dukelec/cdstep/doc/cdstep_v3.jpg

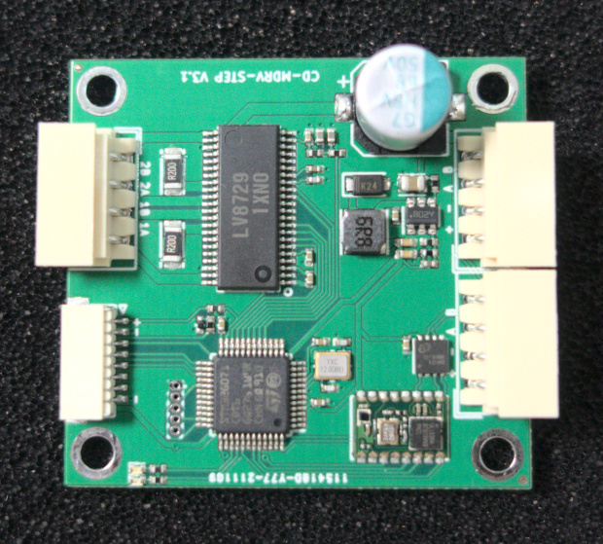
doc/cdstep_v3.jpg
