dukelec/cdstep/hardware/cdstep_pcb_v3.1.png

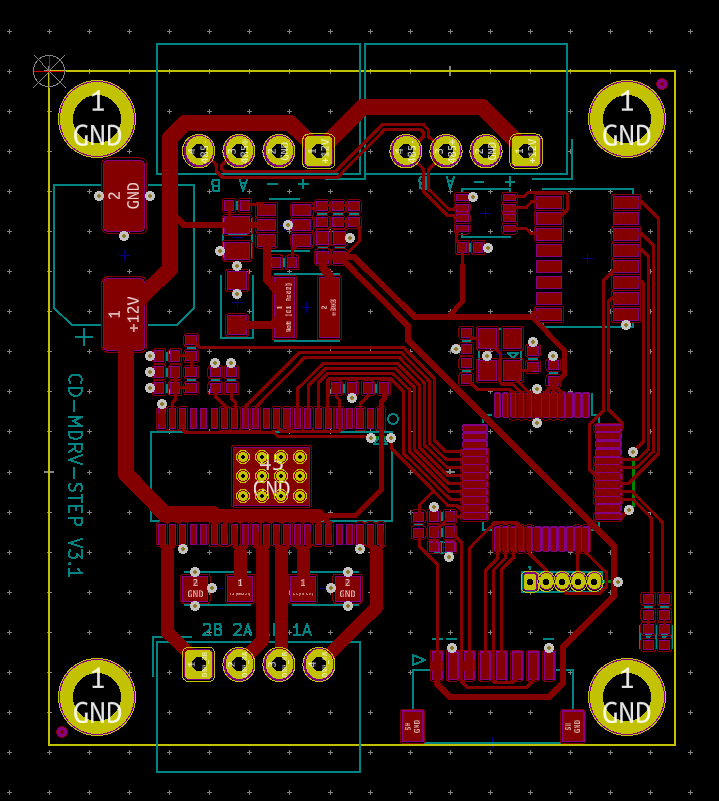
hardware/cdstep_pcb_v3.1.png
