dukelec/cdstep/hardware/cdstep_pcb_v4.1.png

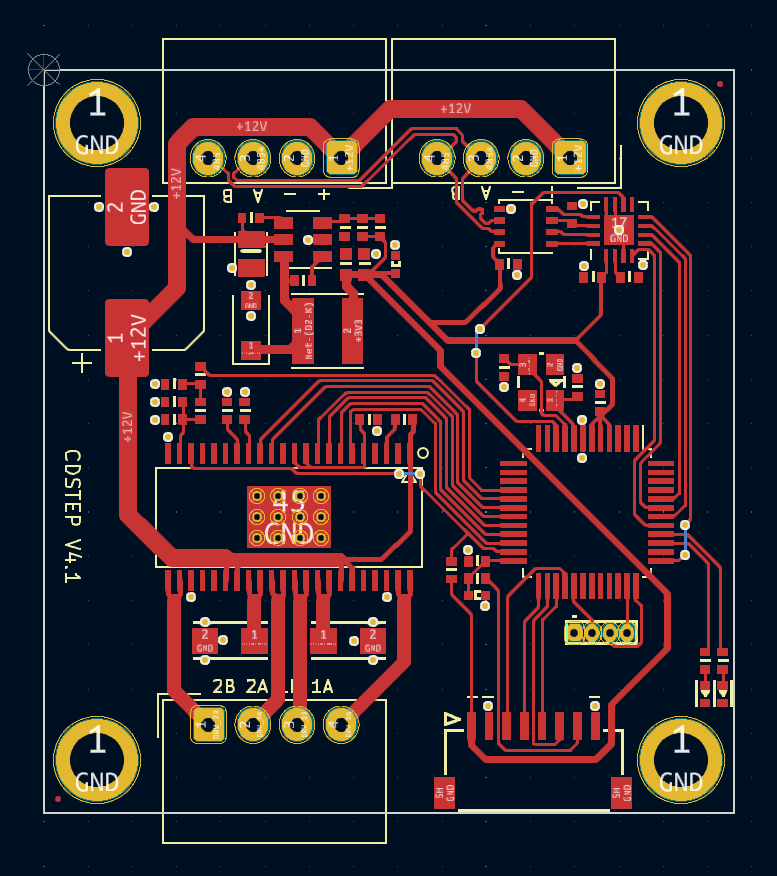
hardware/cdstep_pcb_v4.1.png
