dukelec/cdstep/hardware/cdstep_sch_v4.1.pdf

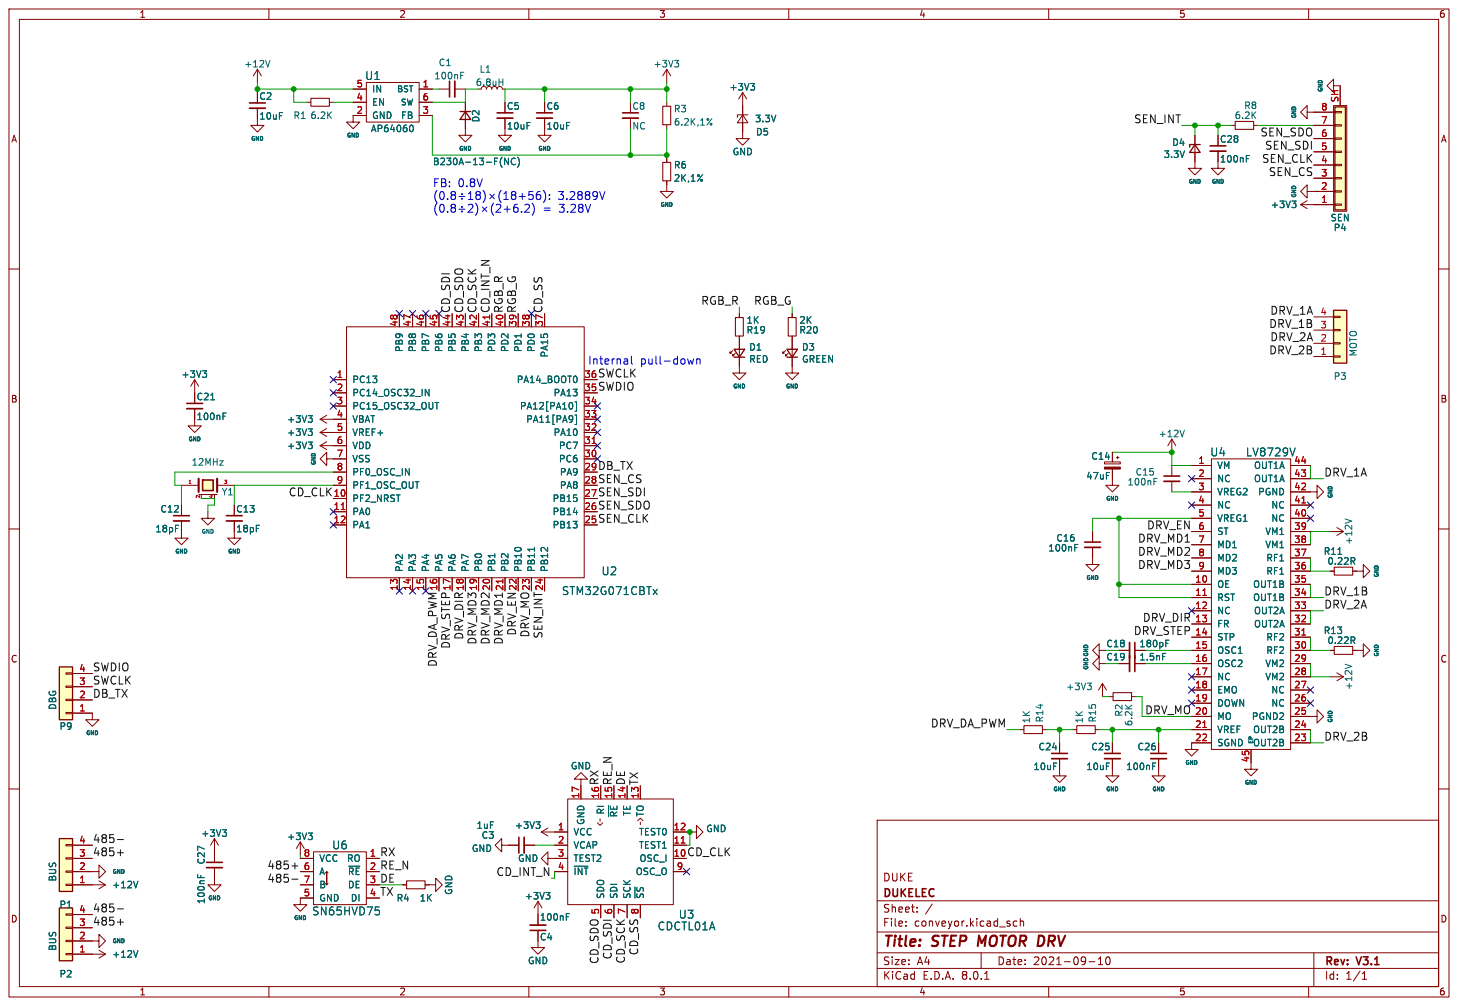
[picture p9: page 1]

DUKE
File: conveyor.kicad_sch Sheet: / DUKELEC

Id: 1/1 Title: STEP MOTOR DRV
