dukelec/cdstep/hardware/cdstep_sch_v3.1.pdf

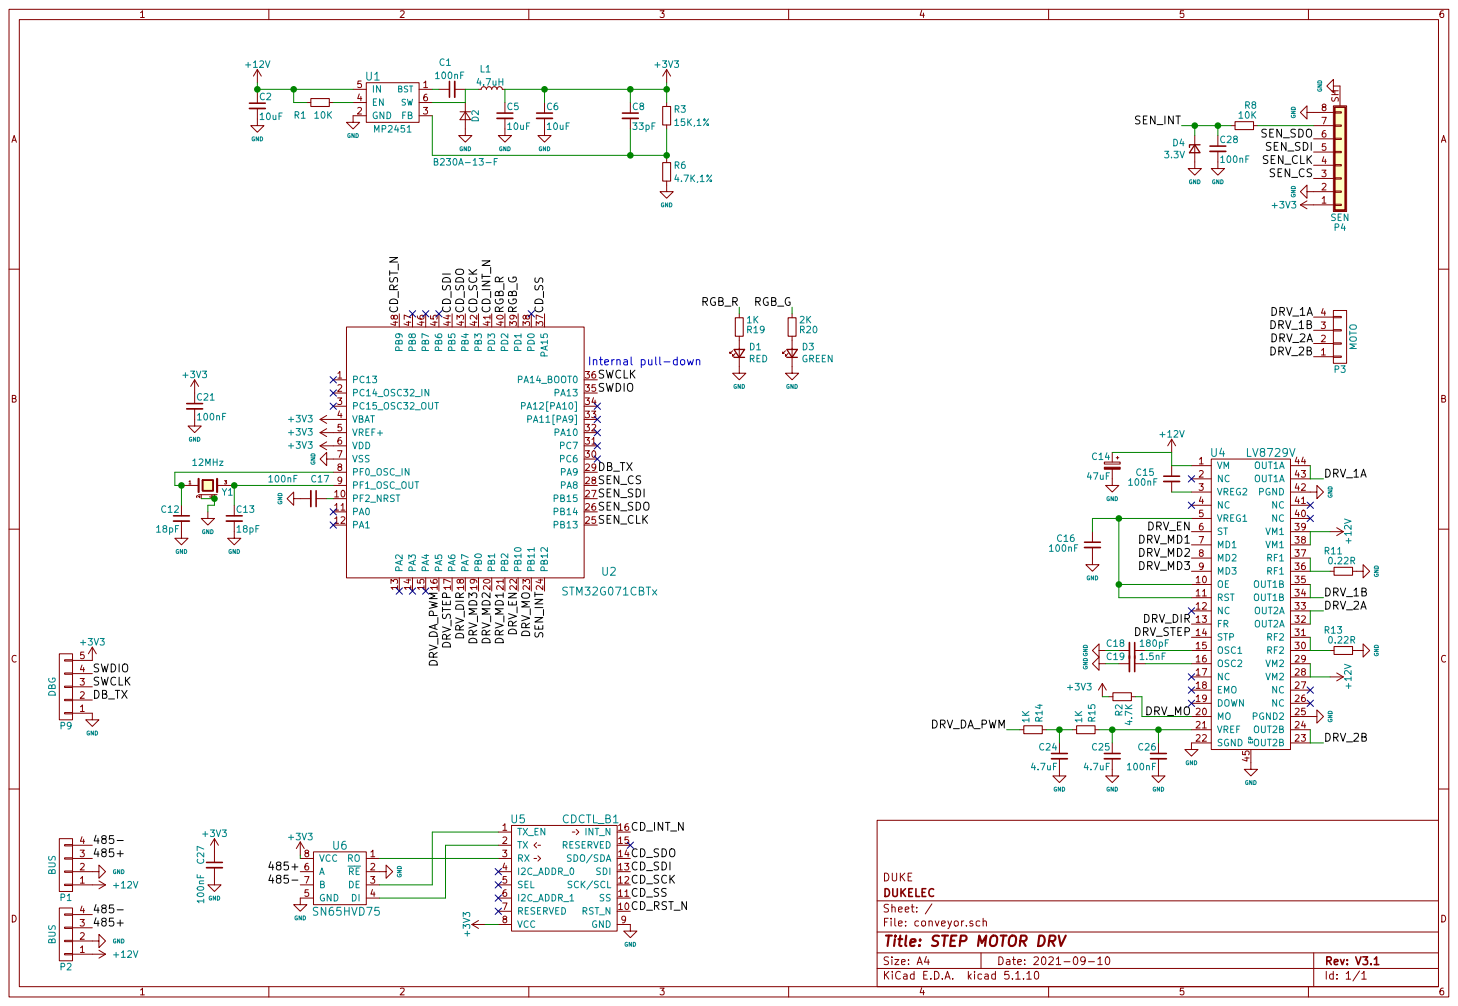
[picture p10: page 1]

DUKE
File: conveyor.sch Sheet: / DUKELEC

Id: 1/1 Title: STEP MOTOR DRV
