dukelec/cdstep/mdrv_bl/usr/app_main.c

/*
 * Software License Agreement (BSD License)
 *
 * Copyright (c) 2017, DUKELEC, Inc.
 * All rights reserved.
 *
 * Author: Duke Fong <d@d-l.io>
 */

#include "app_main.h"

extern SPI_HandleTypeDef hspi1;
extern UART_HandleTypeDef huart1;

uint32_t *bl_args = (uint32_t *)BL_ARGS;

gpio_t led_r = { .group = LED_R_GPIO_Port, .num = LED_R_Pin };
gpio_t led_g = { .group = LED_G_GPIO_Port, .num = LED_G_Pin };

uart_t debug_uart = { .huart = &huart1 };

static gpio_t r_cs = { .group = CD_CS_GPIO_Port, .num = CD_CS_Pin };
static spi_t r_spi = { .hspi = &hspi1, .ns_pin = &r_cs };

static cd_frame_t frame_alloc[FRAME_MAX];
list_head_t frame_free_head = {0};

static cdn_pkt_t packet_alloc[PACKET_MAX];
list_head_t packet_free_head = {0};

cdctl_dev_t r_dev = {0};    // CDBUS
cdn_ns_t dft_ns = {0};      // CDNET


static void device_init(void)
{
    int i;
    cdctl_cfg_t bus_cfg = {
            .mac = csa.mac,
            .baud_l = csa.baud_rate_l,
            .baud_h = csa.baud_rate_h,
            .filter_m = { csa.bus_filter_m[0], csa.bus_filter_m[1] },
            .mode = csa.bus_mode,
            .idle_wait_len = csa.bus_idle_wait_len,
            .tx_permit_len = csa.bus_tx_permit_len,
            .max_idle_len = csa.bus_max_idle_len,
            .tx_pre_len = csa.bus_tx_pre_len
    };
    cdn_init_ns(&dft_ns, &packet_free_head, &frame_free_head);

    for (i = 0; i < FRAME_MAX; i++)
        cd_list_put(&frame_free_head, &frame_alloc[i]);
    for (i = 0; i < PACKET_MAX; i++)
        cdn_list_put(&packet_free_head, &packet_alloc[i]);

    cdctl_dev_init(&r_dev, &frame_free_head, &bus_cfg, &r_spi);
    if (!csa.keep_bl) {
        cdctl_set_baud_rate(&r_dev, 115200, 115200);
        cdctl_flush(&r_dev);
    }

    cdn_add_intf(&dft_ns, &r_dev.cd_dev, 0, csa.mac);
}


#define APP_ADDR 0x08006000 // offset: 24KB

static void jump_to_app(void)
{
    static uint32_t func; // not on stack (MSP switches before use)
    uint32_t stack = *(uint32_t*)APP_ADDR;
    func = *(uint32_t*)(APP_ADDR + 4);

    gpio_set_val(&led_r, 0);
    gpio_set_val(&led_g, 0);
    printf("jump to app...\n");
    while (!__HAL_UART_GET_FLAG(debug_uart.huart, UART_FLAG_TC));
    HAL_UART_DeInit(debug_uart.huart);
    HAL_SPI_DeInit(r_spi.hspi);
    HAL_RCC_DeInit();

    // NOTE: change app's SCB->VTOR in app's system_stm32fxxx.c
    //for(int i = 0; i < 256; i++)
    //    HAL_NVIC_DisableIRQ(i);
    HAL_NVIC_DisableIRQ(SysTick_IRQn);
    __set_MSP(stack); // init stack pointer
    ((void(*)()) func)();
    while (true);
}


void app_main(void)
{
    printf("\nstart app_main (bl)...\n");

    load_conf();
    bool dbg_en_bk = csa.dbg_en;
    csa.keep_bl = *bl_args == 0xcdcd0001;
    if (!csa.keep_bl)
        csa.dbg_en = false; // silence
    delay_systick(50);
    device_init();
    comm_service_init();
    printf("bl conf: %s, bl_args: %08lx\n", csa.conf_from ? "load from flash" : "use default", *bl_args);
    gpio_set_val(&led_g, 1);

    uint32_t t_last = get_systick();
    bool update_baud = csa.keep_bl;

    while (true) {
        if (get_systick() - t_last > (update_baud ? 100000 : 200000) / CD_SYSTICK_US_DIV) {
            t_last = get_systick();
            gpio_set_val(&led_g, !gpio_get_val(&led_g));
        }

        if (!csa.keep_bl && !update_baud && get_systick() > 1000000 / CD_SYSTICK_US_DIV) {
            update_baud = true;
            if (csa.baud_rate_l != 115200 || csa.baud_rate_h != 115200) {
                cdctl_set_baud_rate(&r_dev, csa.baud_rate_l, csa.baud_rate_h);
                cdctl_flush(&r_dev);
            }
            csa.dbg_en = dbg_en_bk;
        }

        if (!csa.keep_bl && get_systick() > 2000000 / CD_SYSTICK_US_DIV)
            jump_to_app();

        cdctl_poll(&r_dev);
        cdn_poll(&dft_ns); // handle cdnet
        comm_service_poll();
    }
}
