dukelec/cdstep/mdrv_fw/Core/Inc/main.h

#define DRV_DIR_Pin GPIO_PIN_7
#define DRV_DIR_GPIO_Port GPIOA
#define DRV_MD3_Pin GPIO_PIN_0
#define DRV_MD3_GPIO_Port GPIOB
#define DRV_MD2_Pin GPIO_PIN_1
#define DRV_MD2_GPIO_Port GPIOB
#define DRV_MD1_Pin GPIO_PIN_2
#define DRV_MD1_GPIO_Port GPIOB
#define DRV_EN_Pin GPIO_PIN_10
#define DRV_EN_GPIO_Port GPIOB
#define DRV_MO_Pin GPIO_PIN_11
#define DRV_MO_GPIO_Port GPIOB
#define SEN_INT_Pin GPIO_PIN_12
#define SEN_INT_GPIO_Port GPIOB
#define SEN_SCK_Pin GPIO_PIN_13
#define SEN_SCK_GPIO_Port GPIOB
#define SEN_SDO_Pin GPIO_PIN_14
#define SEN_SDO_GPIO_Port GPIOB
#define CD_CS_Pin GPIO_PIN_15
#define CD_CS_GPIO_Port GPIOA
#define LED_G_Pin GPIO_PIN_1
#define LED_G_GPIO_Port GPIOD
#define LED_R_Pin GPIO_PIN_2
#define LED_R_GPIO_Port GPIOD
#define CD_INT_Pin GPIO_PIN_3
#define CD_INT_GPIO_Port GPIOD
