dukelec/cdstep/mdrv_fw/usr/comm_service.c

/*
 * Software License Agreement (BSD License)
 *
 * Copyright (c) 2017, DUKELEC, Inc.
 * All rights reserved.
 *
 * Author: Duke Fong <d@d-l.io>
 */

#include "app_main.h"

static char cpu_id[25];
static char info_str[128];
const char sw_ver[] = SW_VER; // vector slot 0x20 points here, for the bl to read
extern const uint32_t g_pfnVectors[]; // ours, right after the bl

static cdn_sock_t sock1 = { .port = 1, .ns = &dft_ns };
static cdn_sock_t sock5 = { .port = 5, .ns = &dft_ns };
static cdn_sock_t sock6 = { .port = 6, .ns = &dft_ns };
static cdn_sock_t sock8 = { .port = 8, .ns = &dft_ns };


static void get_uid(char *buf)
{
    const char tlb[] = "0123456789abcdef";
    int i;

    for (i = 0; i < 12; i++) {
        uint8_t val = *((char *)UID_BASE + i);
        buf[i * 2 + 0] = tlb[val >> 4];
        buf[i * 2 + 1] = tlb[val & 0xf];
    }
    buf[24] = '\0';
}

static uint32_t get_hw_ver(void) // bytes: major, minor, patch -> 0xMMmmpp, 0xffffff if never written
{
    uint32_t ver = 0xffffff;
    for (const uint64_t *p = (uint64_t *)HW_VER_ADDR; p < (uint64_t *)HW_VER_ADDR + 9 && *p != ~0ULL; p++) {
        if (*p == 0) // zeroed, the only overwrite the flash accepts
            continue;
        const uint8_t *b = (const uint8_t *)p;
        ver = b[0] << 16 | b[1] << 8 | b[2];
    }
    return ver;
}

static void get_hw_ver_str(char *buf) // buf[24], "" if never written
{
    uint32_t v = get_hw_ver();
    *buf = '\0';
    if (v != 0xffffff)
        sprintf(buf, (v & 0xff) ? "; HW: v%d.%d.%d" : "; HW: v%d.%d",
                (int)(v >> 16), (int)(v >> 8 & 0xff), (int)(v & 0xff));
}

static void init_info_str(void)
{
    // M: model; S: serial string; HW: hardware version; BL: bl version; SW: software version
    const char *bl_ver = *(const char **)(0x08000000 + 0x20); // 0 in older bls
    bool has_bl = (uint32_t)bl_ver - 0x08000000 < (uint32_t)g_pfnVectors - 0x08000000;

    char hw_ver[24];
    get_uid(cpu_id);
    get_hw_ver_str(hw_ver);
    snprintf(info_str, sizeof(info_str), "M: cdstep; S: %s%s%s%.20s; SW: %s",
             cpu_id, hw_ver, has_bl ? "; BL: " : "", has_bl ? bl_ver : "", sw_ver);
    d_info("info: %s, git: %s\n", info_str, SW_VER_FULL);
}


// device info
static void p1_service_poll(void)
{
    cdn_pkt_t *pkt = cdn_sock_recvfrom(&sock1);
    if (!pkt)
        return;
    uint8_t *rx_dat = pkt->dat;
    pkt->dst = pkt->src;
    cdn_pkt_prepare(&sock1, pkt);

    if (pkt->len == 0) {
        strcpy((char *)pkt->dat, info_str);
        pkt->len = strlen(info_str);
        cdn_sock_sendto(&sock1, pkt);
        csa.conf_from &= 0x7f;
        return;
    }

    // mac address conflicts can be resolved by following:
    if (pkt->len >= 5 && rx_dat[0] == 0x10) {
        uint16_t max_time = get_unaligned16(rx_dat + 1);
        uint16_t wait_time = rand() / (RAND_MAX / max_time);
        uint8_t mac_start = rx_dat[3];
        uint8_t mac_end = rx_dat[4];
        uint8_t local_mac = csa.mac;
        rx_dat[pkt->len] = '\0';
        char *string = (char *)rx_dat + 5;
        d_debug("p1 search: wait %d (%d), [%02x, %02x] (%02x), str: %s\n",
                wait_time, max_time, mac_start, mac_end, local_mac, string);

        if (clip(local_mac, mac_start, mac_end) == local_mac && strstr(info_str, string) != NULL) {
            uint32_t t_last = get_systick();
            while (get_systick() - t_last < wait_time * 1000 / CD_SYSTICK_US_DIV);
            strcpy((char *)pkt->dat, info_str);
            pkt->len = strlen(info_str);
            cdn_sock_sendto(&sock1, pkt);
            csa.conf_from &= 0x7f;
            return;
        } else {
            csa.conf_from |= 0x80;
        }
    }

    d_debug("p1 ser: ignore\n");
    cdn_pkt_free(&dft_ns, pkt);
}


// flash memory manipulation
static void p8_service_poll(void)
{
    // erase:   0x2f, addr_32, len_32  | return [0x00] on success
    // write:   0x20, addr_32 + [data] | return [0x00] on success
    // read:    0x00, addr_32, len_8   | return [0x00, data]
    // cal crc: 0x10, addr_32, len_32  | return [0x00, crc_16]

    cdn_pkt_t *pkt = cdn_sock_recvfrom(&sock8);
    if (!pkt)
        return;
    uint8_t *rx_dat = pkt->dat;
    bool reply = !(rx_dat[0] & 0x80);
    rx_dat[0] &= ~0x80;
    pkt->dst = pkt->src;
    cdn_pkt_prepare(&sock8, pkt);

    if (rx_dat[0] == 0x2f && pkt->len == 9) {
        uint32_t addr = get_unaligned32(rx_dat + 1);
        uint32_t len = get_unaligned32(rx_dat + 5);
        int ret = flash_erase(addr, len);
        pkt->len = 1;
        pkt->dat[0] = ret == HAL_OK ? 0 : 1;

    } else if (rx_dat[0] == 0x00 && pkt->len == 6) {
        uint8_t *src_dat = (uint8_t *) get_unaligned32(rx_dat + 1);
        uint8_t len = min(rx_dat[5], CDN_MAX_PAYLOAD - 1);
        memcpy(pkt->dat + 1, src_dat, len);
        d_verbose("nvm read: %p %d\n", src_dat, len);
        pkt->dat[0] = 0;
        pkt->len = len + 1;

    } else if (rx_dat[0] == 0x20 && pkt->len > 5) {
        uint32_t addr = get_unaligned32(rx_dat + 1);
        uint8_t len = pkt->len - 5;
        int ret = flash_write(addr, len, rx_dat + 5);
        pkt->len = 1;
        pkt->dat[0] = ret == HAL_OK ? 0 : 1;
#if 0
    } else if (rx_dat[0] == 0x10 && pkt->len == 9) {
        uint32_t f_addr = get_unaligned32(rx_dat + 1);
        uint32_t f_len = get_unaligned32(rx_dat + 5);
        uint16_t crc = crc16((const uint8_t *)f_addr, f_len);

        d_debug("nvm crc addr: %x, len: %x, crc: %02x", f_addr, f_len, crc);
        put_unaligned16(crc, pkt->dat + 1);
        pkt->dat[0] = 0;
        pkt->len = 3;
#endif
    } else {
        d_warn("nvm: wrong cmd, len: %d\n", pkt->len);
        cdn_pkt_free(&dft_ns, pkt);
        return;
    }

    if (reply)
        cdn_sock_sendto(&sock8, pkt);
    else
        cdn_pkt_free(&dft_ns, pkt);
}


static uint8_t csa_hook_exec(bool after, uint16_t offset, uint8_t len, uint8_t *dat)
{
    uint8_t ret = 0;
    csa_hook_t *hook = dat ? csa_w_hook : csa_r_hook;
    int hook_num = dat ? csa_w_hook_num : csa_r_hook_num;
    for (int i = 0; i < hook_num; i++) {
        hook_func_t hook_func = after ? hook[i].after : hook[i].before;
        if (hook_func) {
            reg2r_t *regr = &hook[i].range;
            uint16_t start = clip(offset, regr->offset, regr->offset + regr->size);
            uint16_t end = clip(offset + len, regr->offset, regr->offset + regr->size);
            if (start != end)
                ret = hook_func(start - regr->offset, end - start, dat ? (dat + (regr->offset - offset)) : NULL);
        }
    }
    return ret;
}


// csa manipulation
static void p5_service_poll(void)
{
    uint8_t ret_val = 0;
    // read:        0x00, offset_16, len_8   | return [0x00, data]
    // read_dft:    0x01, offset_16, len_8   | return [0x00, data]
    // write:       0x20, offset_16 + [data] | return [0x00] on success

    cdn_pkt_t *pkt = cdn_sock_recvfrom(&sock5);
    if (!pkt)
        return;
    if (csa.conf_from & 0x80) {
        d_warn("csa: avoid cmd, len: %d\n", pkt->len);
        cdn_pkt_free(&dft_ns, pkt);
        return;
    }
    uint8_t *rx_dat = pkt->dat;
    bool reply = !(rx_dat[0] & 0x80);
    rx_dat[0] &= ~0x80;
    pkt->dst = pkt->src;
    cdn_pkt_prepare(&sock5, pkt);

    if (rx_dat[0] == 0x00 && pkt->len == 4) {
        uint16_t protocol_offset = get_unaligned16(rx_dat + 1);
        uint16_t offset;
        uint8_t len = min(rx_dat[3], CDN_MAX_PAYLOAD - 1);

        if (!csa_range_to_internal(protocol_offset, len, &offset))
            ret_val = 1;
        else
            ret_val = csa_hook_exec(false, offset, len, NULL);
        if (!ret_val) {
            // not use local_irq_save, avoid delay encoder spi read
            NVIC_DisableIRQ(TIM1_BRK_UP_TRG_COM_IRQn);
            memcpy(pkt->dat + 1, ((void *) &csa) + offset, len);
            NVIC_EnableIRQ(TIM1_BRK_UP_TRG_COM_IRQn);
            ret_val = csa_hook_exec(true, offset, len, NULL);
        }

        d_debug("csa read: %04x %d\n", protocol_offset, len);
        pkt->dat[0] = ret_val;
        pkt->len = ret_val ? 1 : len + 1;

    } else if (rx_dat[0] == 0x20 && pkt->len > 3) {
        uint16_t protocol_offset = get_unaligned16(rx_dat + 1);
        uint16_t offset;
        uint8_t len = pkt->len - 3;
        uint8_t *src_dat = rx_dat + 3;

        if (!csa_range_to_internal(protocol_offset, len, &offset))
            ret_val = 1;
        else
            ret_val = csa_hook_exec(false, offset, len, src_dat);
        if (!ret_val) {
            for (int i = 0; i < csa_w_allow_num; i++) {
                reg2r_t *regr = csa_w_allow + i;
                uint16_t start = clip(offset, regr->offset, regr->offset + regr->size);
                uint16_t end = clip(offset + len, regr->offset, regr->offset + regr->size);
                if (start == end) {
                    //printf("csa i%d: [%x, %x), [%x, %x) -> [%x, %x)\n",
                    //        i, regr->offset, regr->offset + regr->size,
                    //        offset, offset + len,
                    //        start, end);
                    continue;
                }

                //printf("csa @ %p, %p <- %p, len %d, dat[0]: %x\n",
                //        &csa, ((void *) &csa) + start, src_dat + (start - offset), end - start,
                //        *(src_dat + (start - offset)));
                NVIC_DisableIRQ(TIM1_BRK_UP_TRG_COM_IRQn);
                memcpy(((void *) &csa) + start, src_dat + (start - offset), end - start);
                NVIC_EnableIRQ(TIM1_BRK_UP_TRG_COM_IRQn);
            }
            ret_val = csa_hook_exec(true, offset, len, src_dat);
        }

        d_debug("csa write: %04x %d, ret: %02x\n", protocol_offset, len, ret_val);
        pkt->len = 1;
        pkt->dat[0] = ret_val;

    } else if (rx_dat[0] == 0x01 && pkt->len == 4) {
            uint16_t protocol_offset = get_unaligned16(rx_dat + 1);
            uint16_t offset;
            uint8_t len = min(rx_dat[3], CDN_MAX_PAYLOAD - 1);
            ret_val = csa_range_to_internal(protocol_offset, len, &offset) ? 0 : 1;
            if (!ret_val)
                memcpy(pkt->dat + 1, ((void *) &csa_dft) + offset, len);
            d_debug("csa read_dft: %04x %d\n", protocol_offset, len);
            pkt->dat[0] = ret_val;
            pkt->len = ret_val ? 1 : len + 1;

    } else {
        d_warn("csa: wrong cmd, len: %d\n", pkt->len);
        cdn_pkt_free(&dft_ns, pkt);
        return;
    }

    if (reply)
        cdn_sock_sendto(&sock5, pkt);
    else
        cdn_pkt_free(&dft_ns, pkt);
}

// qxchg
static void p6_service_poll(void)
{
    uint8_t ret_val = 0;
    cdn_pkt_t *pkt = cdn_sock_recvfrom(&sock6);
    if (!pkt)
        return;
    bool mcast = !!(pkt->src.port & 0x10);
    bool reply = !(pkt->src.port & 0x08);
    pkt->dst = pkt->src;
    cdn_pkt_prepare(&sock5, pkt);
    uint8_t *src_dat = pkt->dat;
    uint8_t *dst_dat = pkt->dat;

    if (mcast) { // multicast
        if (csa.qxchg_mcast.offset + csa.qxchg_mcast.size <= pkt->len) {
            memmove(pkt->dat, pkt->dat + csa.qxchg_mcast.offset, csa.qxchg_mcast.size);
            pkt->len = csa.qxchg_mcast.size;
        } else {
            d_warn("qxchg: wrong cmd, len: %d\n", pkt->len);
            cdn_pkt_free(&dft_ns, pkt);
            return;
        }
    }

    for (int i = 0; !ret_val && i < 4; i++) {
        regr_t *regr = csa.qxchg_set + i;
        uint16_t lim_size = min(pkt->len - (src_dat - pkt->dat), regr->size);
        if (!lim_size)
            break;
        uint16_t offset;
        if (!csa_range_to_internal(regr->offset, lim_size, &offset))
            ret_val = 1;
        else
            ret_val = csa_hook_exec(false, offset, lim_size, src_dat);
        if (!ret_val) {
            NVIC_DisableIRQ(TIM1_BRK_UP_TRG_COM_IRQn);
            memcpy(((void *) &csa) + offset, src_dat, lim_size);
            NVIC_EnableIRQ(TIM1_BRK_UP_TRG_COM_IRQn);
            ret_val = csa_hook_exec(true, offset, lim_size, src_dat);
        }
        src_dat += lim_size;
    }

    for (int i = 0; !ret_val && i < 5; i++) {
        regr_t *regr = csa.qxchg_ret + i;
        if (!regr->size)
            break;
        uint16_t offset;
        if (!csa_range_to_internal(regr->offset, regr->size, &offset))
            ret_val = 1;
        else
            ret_val = csa_hook_exec(false, offset, regr->size, NULL);
        if (!ret_val) {
            NVIC_DisableIRQ(TIM1_BRK_UP_TRG_COM_IRQn);
            memcpy(dst_dat, ((void *) &csa) + offset, regr->size);
            NVIC_EnableIRQ(TIM1_BRK_UP_TRG_COM_IRQn);
            ret_val = csa_hook_exec(true, offset, regr->size, NULL);
        }
        if (!ret_val)
            dst_dat += regr->size;
    }

    pkt->len = ret_val ? 0 : dst_dat - pkt->dat;
    d_debug("qxchg: i %d, o %d\n", src_dat - pkt->dat, pkt->len);
    if (reply)
        cdn_sock_sendto(&sock6, pkt);
    else
        cdn_pkt_free(&dft_ns, pkt);
}


void comm_service_init(void)
{
    cdn_sock_bind(&sock6);
    cdn_sock_bind(&sock5);
    cdn_sock_bind(&sock8);
    cdn_sock_bind(&sock1);
    init_info_str();
    uint32_t *u_id = (uint32_t *)UID_BASE;
    srand(u_id[0] + u_id[1] + u_id[2] + get_systick());
}

void comm_service_poll(void)
{
    if (csa.save_conf) {
        csa.save_conf = false;
        save_conf();
    }
    if (csa.do_reboot) {
        *(uint32_t *)BL_ARGS = 0xcdcd0000 | csa.do_reboot;
        NVIC_SystemReset();
    }
    p1_service_poll();
    p5_service_poll();
    p6_service_poll();
    p8_service_poll();
}


// for printf
int _write(int file, char *data, int len)
{
    if (csa.dbg_en) {
        cd_frame_t *frm = cd_list_get(&frame_free_head);
        if (frm) {
            len = min(CDN_MAX_PAYLOAD, len);
            frm->dat[0] = csa.mac;
            frm->dat[1] = 0x0;
            frm->dat[2] = 2 + len;
            frm->dat[3] = 64;
            frm->dat[4] = 9;
            memcpy(frm->dat + 5, data, len);
            cdctl_send_frame(&r_dev.cd_dev, frm);
            return len;
        }
    }

    arch_dbg_tx((uint8_t *)data, len);
    return len;
}
