dukelec/cdstep/(commit log)

2018-03-27 stm32cube: set limit_det and cdctl_int_n pin as falling detect
2018-03-27 go home after power up
2018-04-26 rearrange folder; add hw schematic
2018-10-16 fix: forget to call cdnet_intf_register
    [app_main.c]
2019-11-16 update to v2.0 hw by stm32cube
2019-11-17 change cdctl_it to cdctl, new spi hal not stable for dma xfer
2019-12-28 fix typo for read pos command
    [app_motor.c]
2020-10-24 clip not work for float and uint32_t
    [app_main.c, app_main.h, app_motor.c, common_services.c, config.c]
2020-10-24 updated stm32cube to solve the problem of cdctl_it driver hanging caused by spi interrupt loss
2020-10-24 fix the error of reverse movement
    [app_motor.c, config.c, raw_dbg.c]
2021-02-04 add pcb v3.0 sch
2021-02-26 reinit by cube for stm32g0
2021-02-26 enable crystal for bl; or we need de-init rcc
2021-02-26 before solve spi dma problem; restore dma tx and rx interrupt priority to the same
    [app_main.c, config.c, mdrv_fw.ioc]
2021-02-26 spi dma: make sure both tx and rx are completed before calling user callback
2021-02-27 csa list: add ref_volt (motor reference voltage)
2021-02-27 restore position limit isr; stop t_curve when disable motor
2021-02-27 plot: fix incomplete curve tail
    [app_motor.c, raw_dbg.c]
2021-03-21 re-add search device function to port 1, used to resolve mac conflicts
    [app_main.h, common_services.c, config.c]
2021-03-21 the limit switch requires the set_home command now
2021-03-21 prevent the limit from being triggered repeatedly
    [app_motor.c]
2021-08-01 making the timer more accurate
2021-08-01 try fix the unstoppable vibration
    [app_motor.c]
2021-08-01 try fix the unstoppable vibration 2
    [app_motor.c]
2021-08-01 try fix the unstoppable vibration 3
    [app_main.h, app_motor.c]
2021-08-03 fix overrun planning for t curve
    [app_main.h, app_motor.c]
2021-08-09 send pulse by pwm
2021-08-09 add pid
2021-08-11 avoid pwm glitch
2021-11-27 avoid pwm glitch 2
    [app_motor.c]
2021-11-29 elegant pause pwm to avoid counting errors
    [app_motor.c, mdrv_fw.ioc]
2021-11-29 red led waring for microstep check
2022-03-27 simplify pid; improve set_home
2022-05-26 add lim_en to enable/disable limit switch
2022-09-14 not save microstep for limit switch
2022-09-25 read drv_mo pin from csa for debug
2022-09-27 add time space before and after drv_dir switch (not necessary)
2022-09-27 fix issue when tc_speed set lower during running
    [app_motor.c]
2022-11-01 fix set home function
    [app_motor.c]
2024-01-18 restore ld file of bl; replace string mdrv to cdstep
    [common_services.c]
2024-03-24 upload v4.1 hardware schematic
2024-03-30 stm32cube update 1/2
2024-03-31 stm32cube update 2/2
2024-07-29 check all led during power on
2024-07-29 update by stm32cube
2024-08-07 bl: fix poor reset of hw_v3 cdctl-b
    [app_main.c, main.h, mdrv_bl.ioc]
2025-02-18 supports software reboot selection
    [app_main.c, app_main.h, common_services.c, config.c, raw_dbg.c]
2025-11-06 change plot x-axis cnt from 4 bytes to 2 bytes
2025-11-11 fix qxchg partial write issue
    [common_services.c]
2026-02-07 update cdnet, adjust buf_cfg.mode definition; pid: switch to pi control
2026-11-05 info: append the HW version from otp and the BL version
    Vector slot 0x20 points to sw_ver in both bl and app, the app shows the BL
    version before SW when the pointer falls in the bl region.
    HW version: otp 0x1fff7008, 9 slots, the last written one wins.
    tools/hw_ver.py writes it through port 8 (default 4.2), add the pycdnet submodule.
    flash_erase refuses addresses outside the main flash.
